PSUScience/universal-optics/Scatter Tank/Solidworks Files/Box Assembly.SLDASM

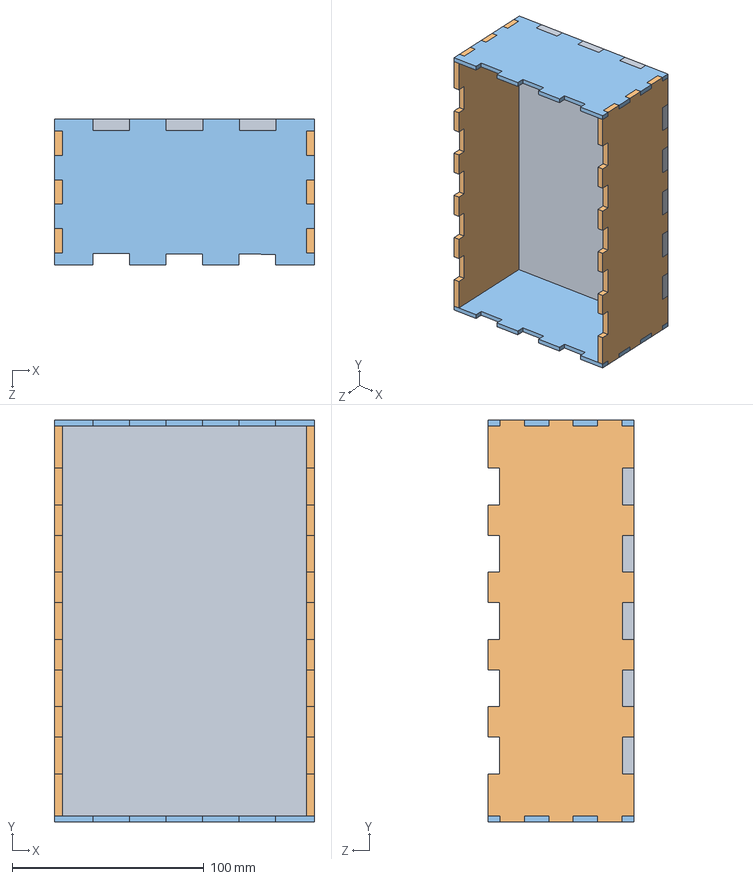
[picture p17: CAD file, 2016-07-11]
Scatter Tank/Solidworks Files/Box Assembly.SLDASM
135.7 x 209.6 x 76.2 mm
Base
long side x 2
short side x 2
