PSUScience/universal-optics/Air Lens/Solidworks Files/air lens mount.SLDPRT

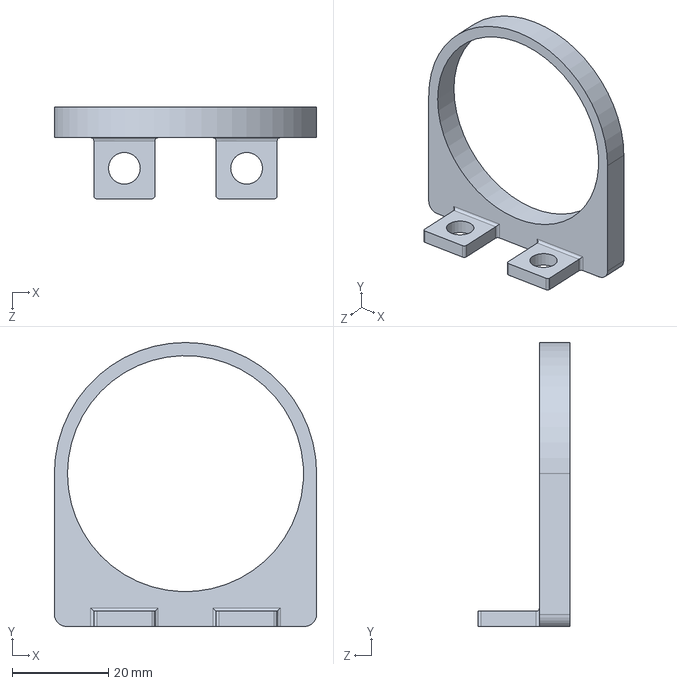
[picture p18: CAD file, 2016-07-11]
Air Lens/Solidworks Files/air lens mount.SLDPRT
54.5 x 59.0 x 19.1 mm
