PSUScience/universal-optics/Color LED Box/Solidworks Files/Color LED Lid.SLDPRT

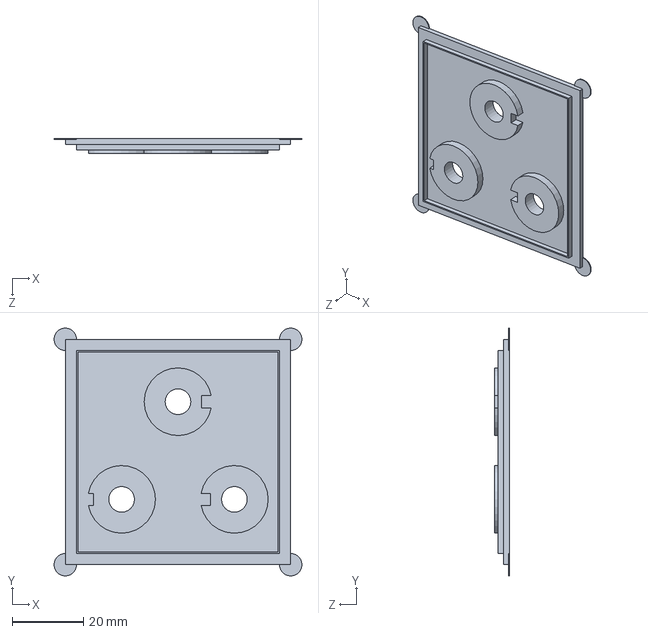
[picture p19: CAD file, 2016-07-11]
Color LED Box/Solidworks Files/Color LED Lid.SLDPRT
69.8 x 69.8 x 4.13 mm
