PSUScience/universal-optics/Foam Core Box/Solidworks Files/T Bracket.SLDPRT

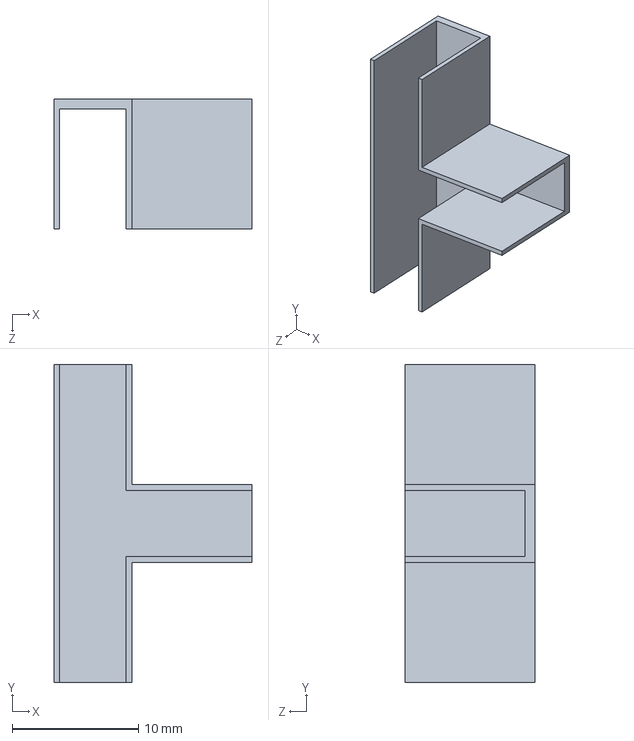
[picture p20: CAD file, 2016-07-11]
Foam Core Box/Solidworks Files/T Bracket.SLDPRT
15.7 x 25.2 x 10.3 mm
