PSUScience/universal-optics/Laser Stand/Solidworks Files/Laser Mount.SLDPRT

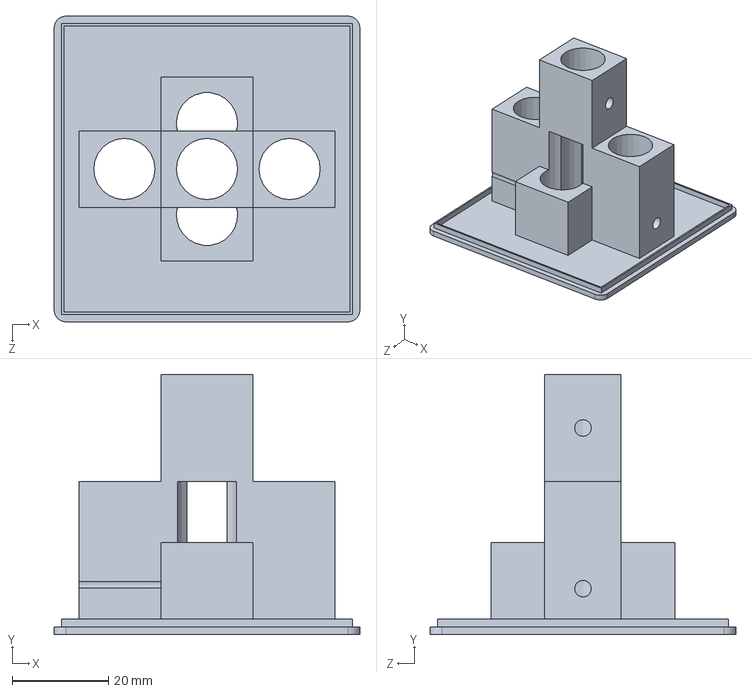
[picture p21: CAD file, 2016-07-11]
Laser Stand/Solidworks Files/Laser Mount.SLDPRT
63.5 x 54.0 x 63.5 mm
