PSUScience/universal-optics/Lens Holders/Solidworks Files/Diffraction Grating Holder.SLDPRT

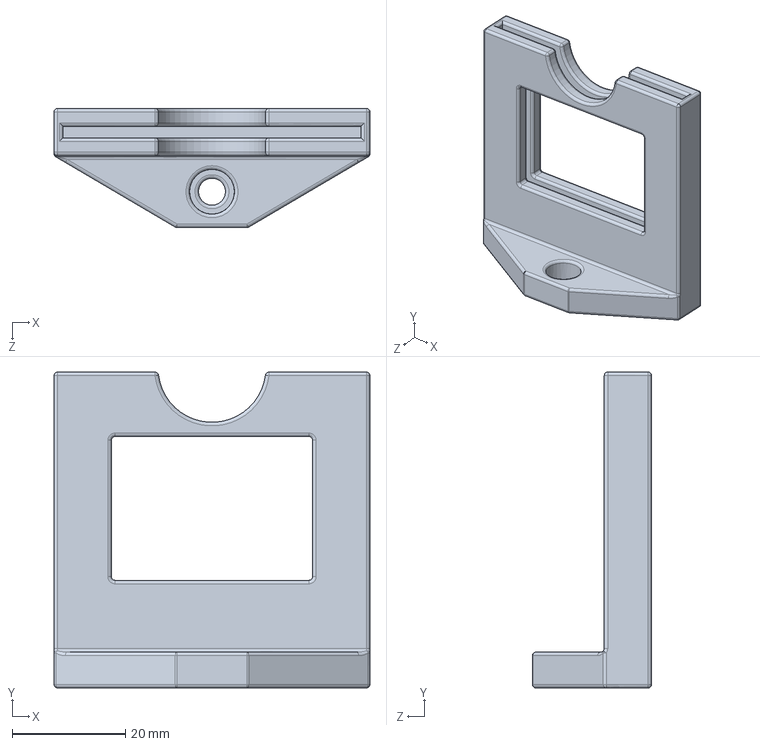
[picture p22: CAD file, 2016-07-11]
Lens Holders/Solidworks Files/Diffraction Grating Holder.SLDPRT
55.9 x 55.9 x 21.1 mm
