PSUScience/universal-optics/Scatter Tank/Solidworks Files/Long Side.SLDPRT

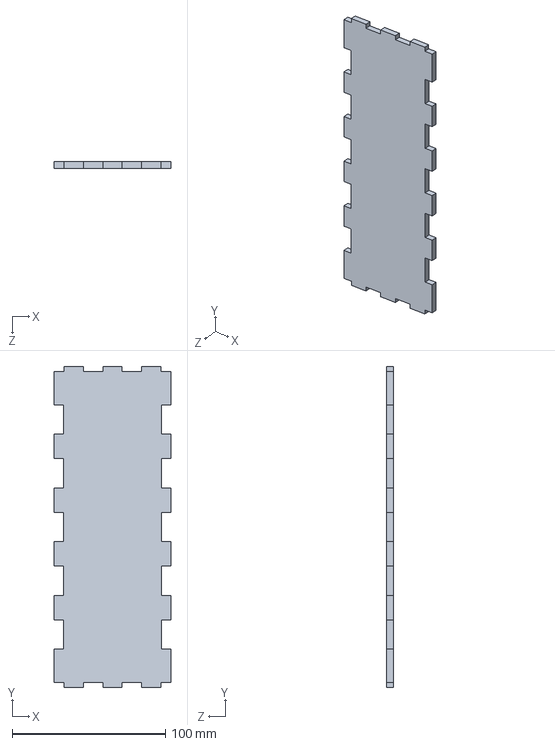
[picture p23: CAD file, 2016-07-11]
Scatter Tank/Solidworks Files/Long Side.SLDPRT
76.2 x 209.5 x 4.34 mm
