PSUScience/universal-optics/White Light Source/Solidworks Files/White Light Source Cover.SLDPRT

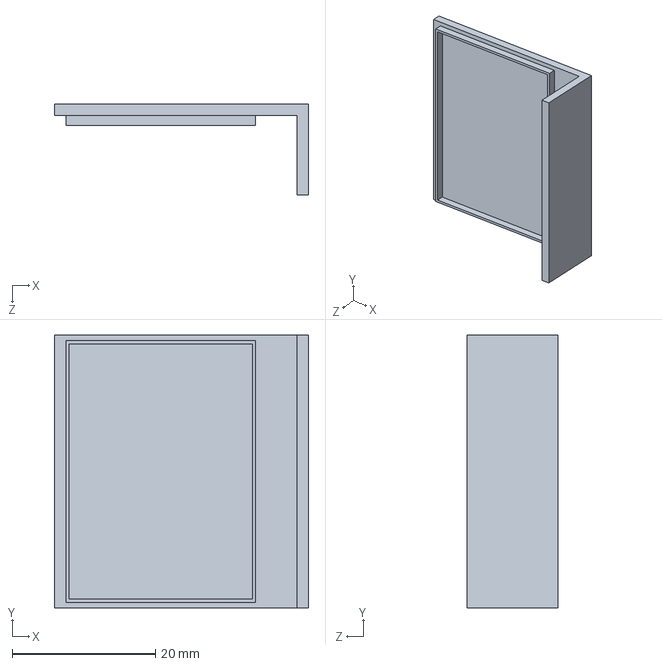
[picture p24: CAD file, 2016-07-11]
White Light Source/Solidworks Files/White Light Source Cover.SLDPRT
35.5 x 38.1 x 12.7 mm
