PSUScience/universal-optics/Color LED Box/Solidworks Files/Color LED Box.SLDPRT

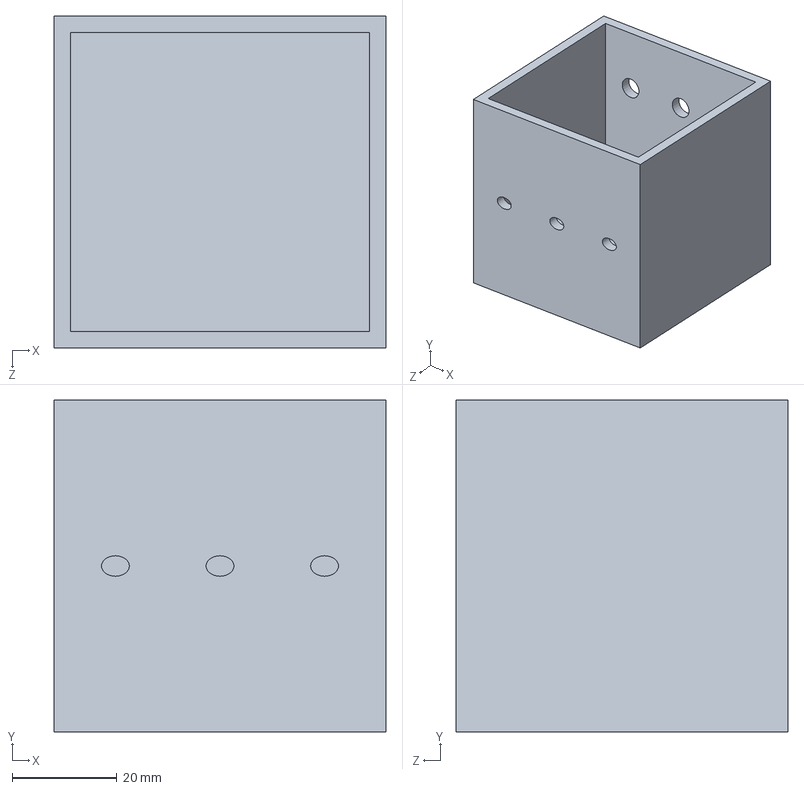
[picture p25: CAD file, 2016-07-11]
Color LED Box/Solidworks Files/Color LED Box.SLDPRT
63.5 x 63.5 x 63.5 mm
