PSUScience/universal-optics/Foam Core Box/Solidworks Files/Corner Bracket.SLDPRT

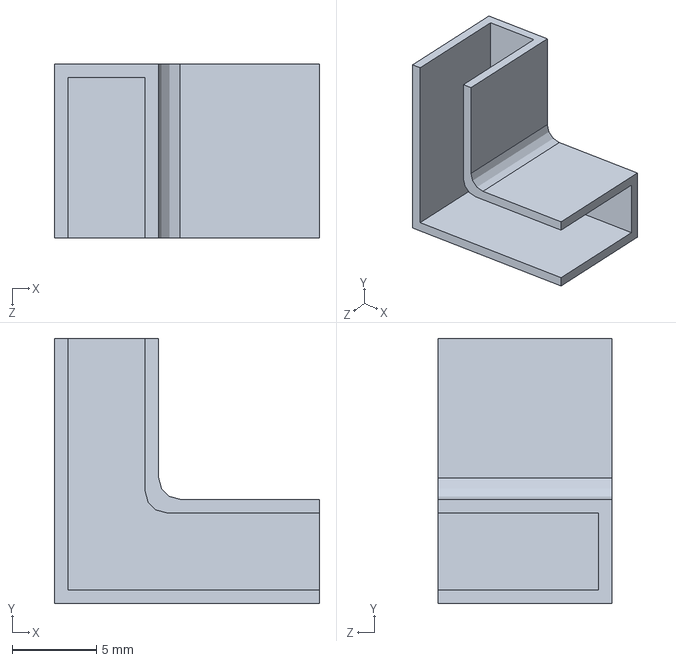
[picture p26: CAD file, 2016-07-11]
Foam Core Box/Solidworks Files/Corner Bracket.SLDPRT
15.7 x 15.7 x 10.3 mm
