PSUScience/universal-optics/Laser Stand/Solidworks Files/Laser Box.SLDPRT

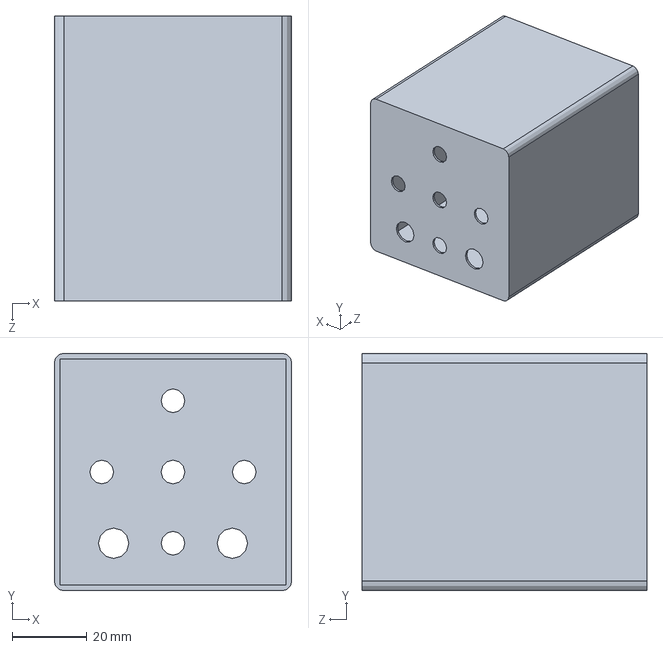
[picture p27: CAD file, 2016-07-11]
Laser Stand/Solidworks Files/Laser Box.SLDPRT
63.5 x 63.5 x 76.2 mm
