PSUScience/universal-optics/Lens Holders/Solidworks Files/50mm Lens Holder - Hanging - Thick.SLDPRT

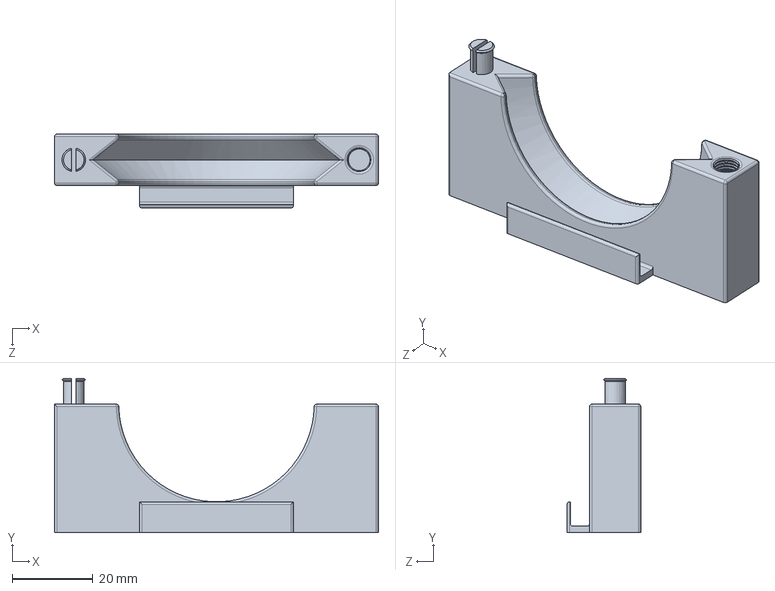
[picture p28: CAD file, 2016-07-11]
Lens Holders/Solidworks Files/50mm Lens Holder - Hanging - Thick.SLDPRT
80.0 x 38.1 x 18.2 mm
