PSUScience/universal-optics/Scatter Tank/Solidworks Files/Base.SLDPRT

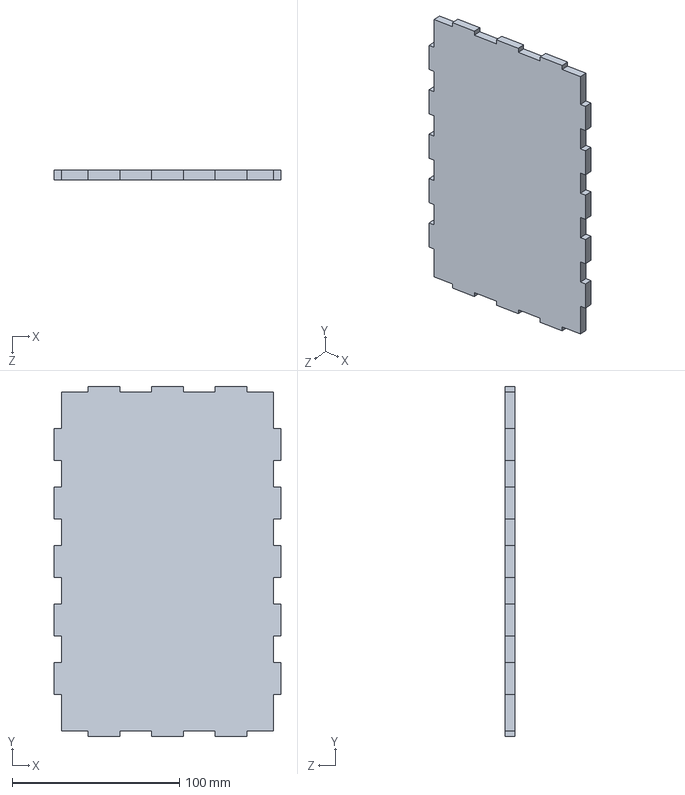
[picture p29: CAD file, 2016-07-11]
Scatter Tank/Solidworks Files/Base.SLDPRT
135.7 x 209.5 x 6.05 mm
