PSUScience/universal-optics/White Light Source/Solidworks Files/White Light Source.SLDPRT

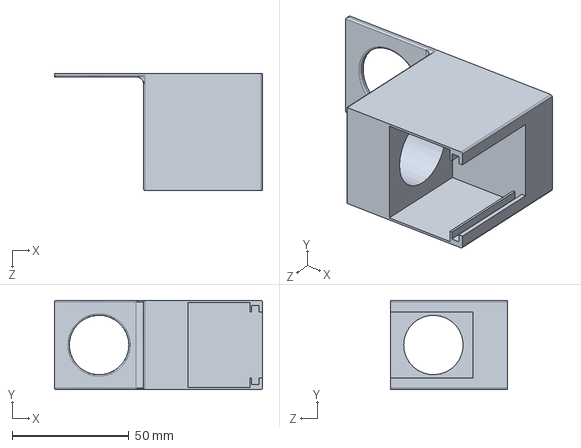
[picture p30: CAD file, 2016-07-11]
White Light Source/Solidworks Files/White Light Source.SLDPRT
88.9 x 38.1 x 50.2 mm
