PSUScience/universal-optics/Foam Core Box/Solidworks Files/Lid Bracket.SLDPRT

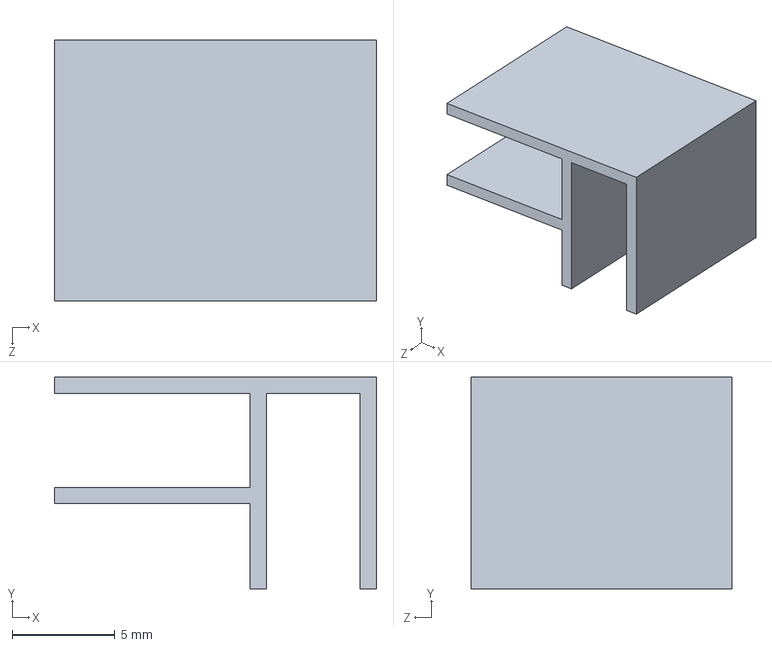
[picture p31: CAD file, 2016-07-11]
Foam Core Box/Solidworks Files/Lid Bracket.SLDPRT
15.7 x 10.3 x 12.7 mm
