PSUScience/universal-optics/Lens Holders/Solidworks Files/50mm Lens Holder - Hanging - Thin.SLDPRT

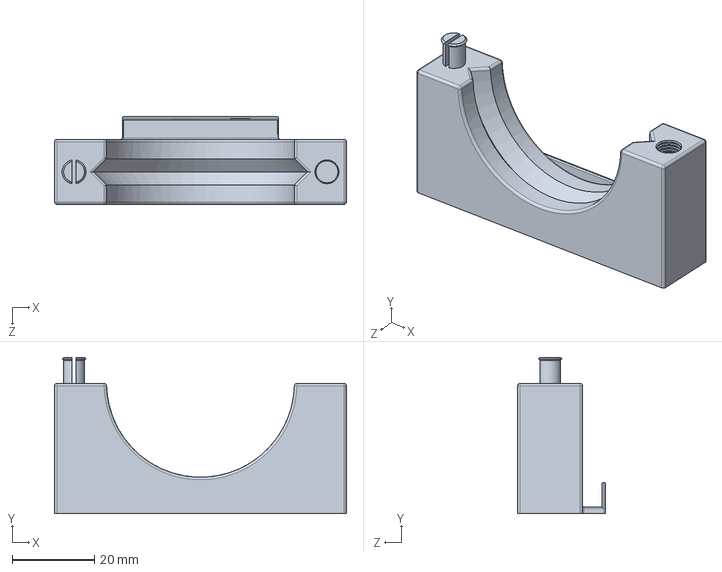
[picture p32: CAD file, 2016-07-11]
Lens Holders/Solidworks Files/50mm Lens Holder - Hanging - Thin.SLDPRT
71.1 x 38.1 x 21.4 mm
