PSUScience/universal-optics/Scatter Tank/Solidworks Files/Short Side.SLDPRT

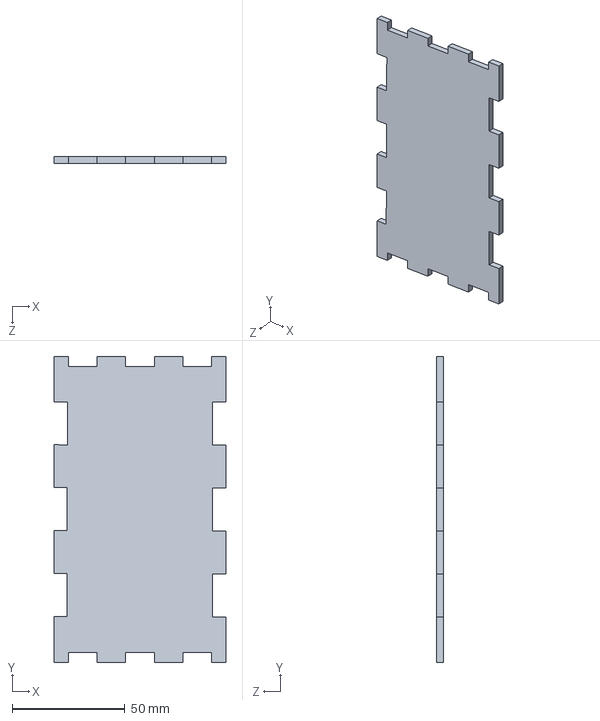
[picture p33: CAD file, 2016-07-11]
Scatter Tank/Solidworks Files/Short Side.SLDPRT
76.2 x 135.7 x 3.17 mm
