PSUScience/universal-optics/Lens Holders/Solidworks Files/50mm Lens Holder - Bottom - Thick.SLDPRT

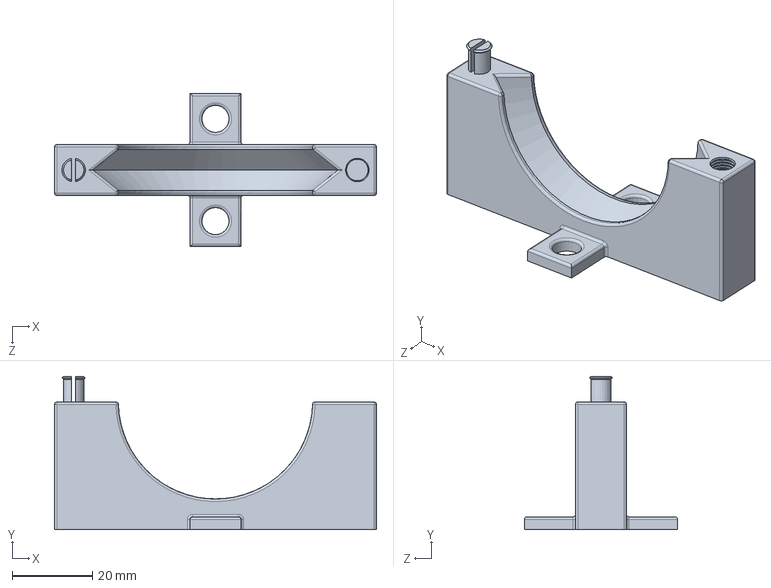
[picture p34: CAD file, 2016-07-11]
Lens Holders/Solidworks Files/50mm Lens Holder - Bottom - Thick.SLDPRT
80.0 x 38.1 x 38.1 mm
