PSUScience/universal-optics/Lens Holders/Solidworks Files/50mm Lens Holder - Top - Thin.SLDPRT

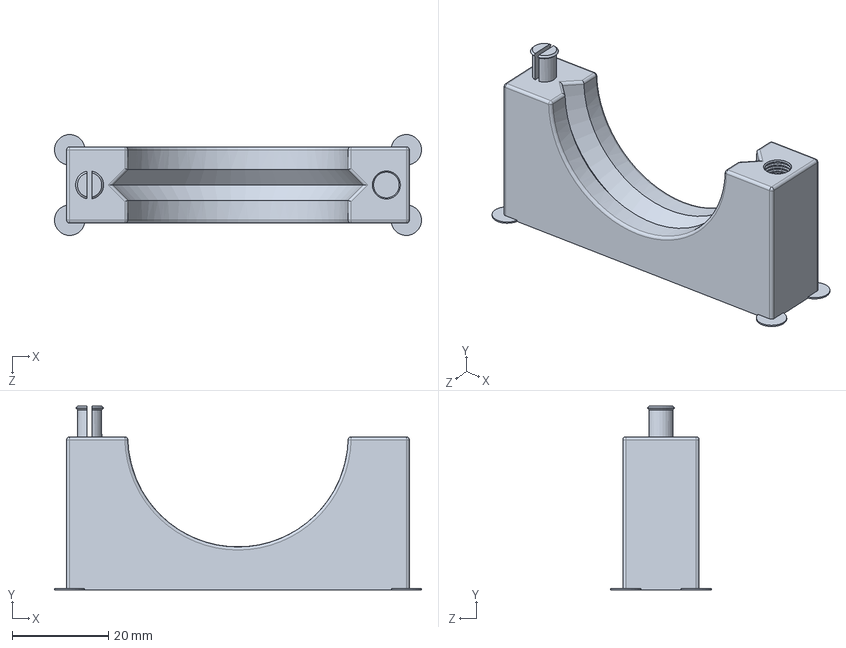
[picture p35: CAD file, 2016-07-11]
Lens Holders/Solidworks Files/50mm Lens Holder - Top - Thin.SLDPRT
76.2 x 38.1 x 20.9 mm
