PSUScience/universal-optics/Lens Holders/Solidworks Files/50mm Lens Holder - Top - Thick.SLDPRT

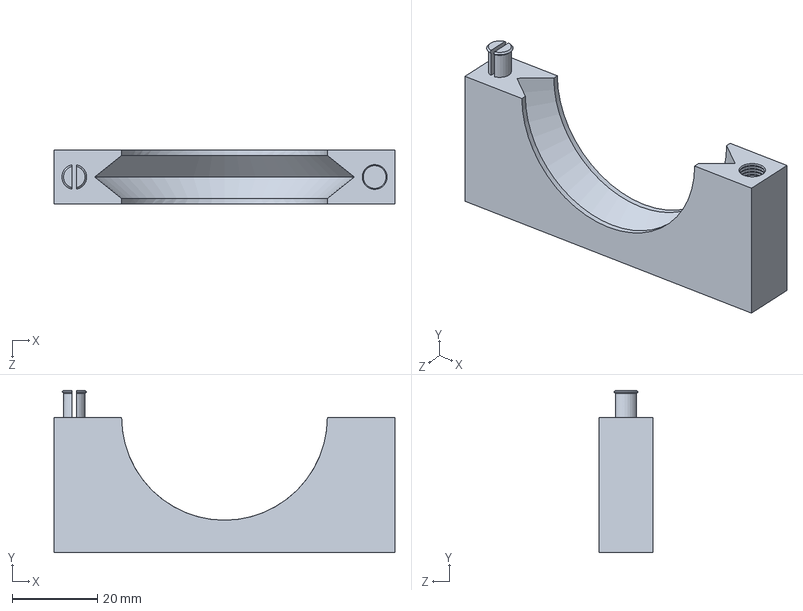
[picture p36: CAD file, 2016-07-11]
Lens Holders/Solidworks Files/50mm Lens Holder - Top - Thick.SLDPRT
80.0 x 38.1 x 12.7 mm
