PSUScience/universal-optics/Lens Holders/Solidworks Files/50 mm Lens Holder - Bottom - Thin.SLDPRT

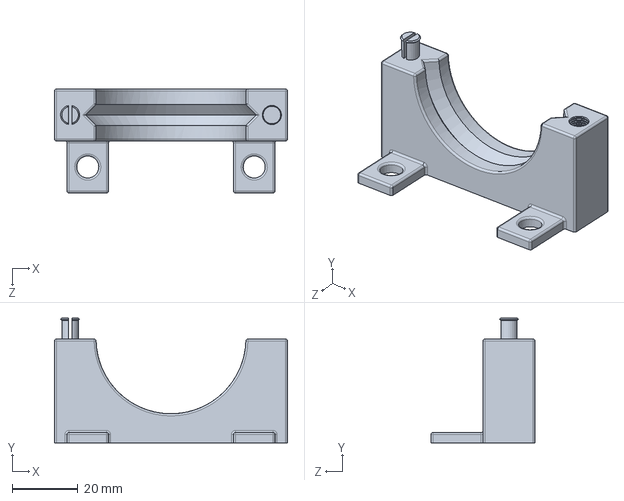
[picture p37: CAD file, 2016-07-11]
Lens Holders/Solidworks Files/50 mm Lens Holder - Bottom - Thin.SLDPRT
71.1 x 38.1 x 31.8 mm
