PSUScience/universal-optics/(list of files, cad)

Other CAD files:
Air Lens/STL Files/air lens mount.STL
Color LED Box/STL Files/Color LED Box.STL
Color LED Box/STL Files/Color LED Lid.STL
Foam Core Box/STL Files/Corner Bracket.STL
Foam Core Box/STL Files/Lid Bracket.STL
Foam Core Box/STL Files/T bracket.STL
Laser Stand/STL Files/Laser Box.STL
Laser Stand/STL Files/Laser Mount.STL
Lens Holders/STL Files/50 mm Lens Holder - Bottom - Thin.STL
Lens Holders/STL Files/50mm Lens Holder - Bottom - Thick.STL
Lens Holders/STL Files/50mm Lens Holder - Hanging - Thick.STL
Lens Holders/STL Files/50mm Lens Holder - Hanging - Thin.STL
Lens Holders/STL Files/50mm Lens Holder - Top - Thick.STL
Lens Holders/STL Files/50mm Lens Holder - Top- Thin.STL
Scatter Tank/Box Assembly.STL
Scatter Tank/DXF Files/Base.DXF
Scatter Tank/DXF Files/Long Side.DXF
Scatter Tank/DXF Files/Short Side.DXF
White Light Source/STL Files/White Light Source Cover.STL
