PSUScience/universal-optics/(commit log)

2016-07-11 First Upload
    Includes initial files, and file structure.
    [50 mm Lense Holder - Bottom - Thin.SLDPRT, 50 mm Lense Holder - Bottom - Thin.STL, 50mm Lense Holder - Bottom - Thick.SLDPRT, 50mm Lense Holder - Bottom - Thick.STL, 50mm Lense Holder - Hanging - Thick.SLDPRT, 50mm Lense Holder - Hanging - Thick.STL, 50mm Lense Holder - Hanging - Thin.SLDPRT, 50mm Lense Holder - Hanging - Thin.STL]
2016-07-11 I made some changes
    Changes were made
    [50 mm Lens Holder - Bottom - Thin.SLDPRT, 50 mm Lens Holder - Bottom - Thin.STL, 50mm Lens Holder - Bottom - Thick.SLDPRT, 50mm Lens Holder - Bottom - Thick.STL, 50mm Lens Holder - Hanging - Thick.SLDPRT, 50mm Lens Holder - Hanging - Thick.STL, 50mm Lens Holder - Hanging - Thin.SLDPRT, 50mm Lens Holder - Hanging - Thin.STL]
2016-07-11 Deleted many spelling errors
    Deleted many spelling errors
    [50 mm Lense Holder - Bottom - Thin.SLDPRT, 50 mm Lense Holder - Bottom - Thin.STL, 50mm Lense Holder - Bottom - Thick.SLDPRT, 50mm Lense Holder - Bottom - Thick.STL, 50mm Lense Holder - Hanging - Thick.SLDPRT, 50mm Lense Holder - Hanging - Thick.STL, 50mm Lense Holder - Hanging - Thin.SLDPRT, 50mm Lense Holder - Hanging - Thin.STL]
2016-07-12 Deleted Everything
    [50 mm Lens Holder - Bottom - Thin.SLDPRT, 50 mm Lens Holder - Bottom - Thin.STL, 50mm Lens Holder - Bottom - Thick.SLDPRT, 50mm Lens Holder - Bottom - Thick.STL, 50mm Lens Holder - Hanging - Thick.SLDPRT, 50mm Lens Holder - Hanging - Thick.STL, 50mm Lens Holder - Hanging - Thin.SLDPRT, 50mm Lens Holder - Hanging - Thin.STL]
2016-07-15 Revert "Deleted Everything"
    This reverts commit 65904a6cd60e010e749e5db1a5ac4144e974b008.
    [50 mm Lens Holder - Bottom - Thin.SLDPRT, 50 mm Lens Holder - Bottom - Thin.STL, 50mm Lens Holder - Bottom - Thick.SLDPRT, 50mm Lens Holder - Bottom - Thick.STL, 50mm Lens Holder - Hanging - Thick.SLDPRT, 50mm Lens Holder - Hanging - Thick.STL, 50mm Lens Holder - Hanging - Thin.SLDPRT, 50mm Lens Holder - Hanging - Thin.STL]
